crteensy/zeptoELRS/zepto_receiver_elrs_3d_top.png

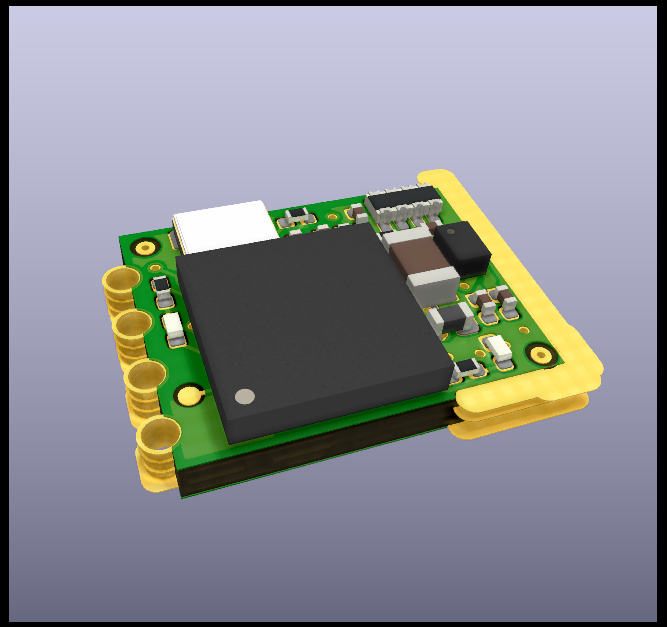
zepto_receiver_elrs_3d_top.png
