crteensy/zeptoELRS/zepto_receiver_elrs_3d_bot.png

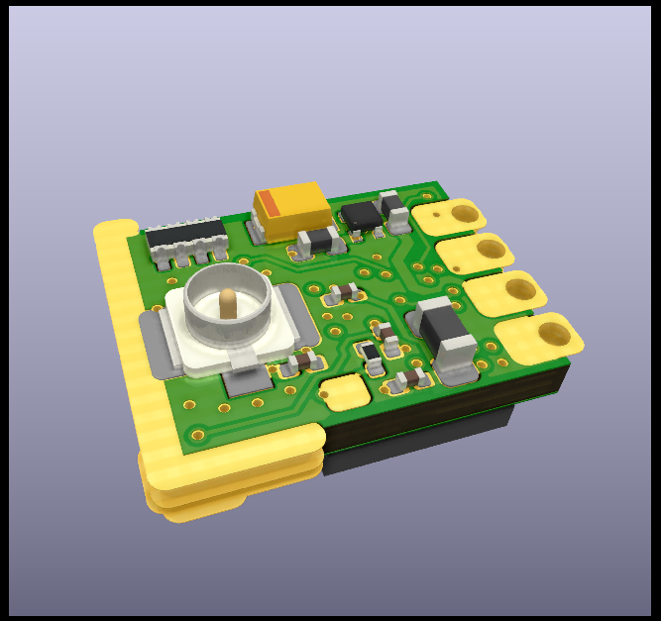
zepto_receiver_elrs_3d_bot.png
