crteensy/zeptoELRS/simulation/simple_plane_low_granularity/simple_plane_model_low_granularity.png

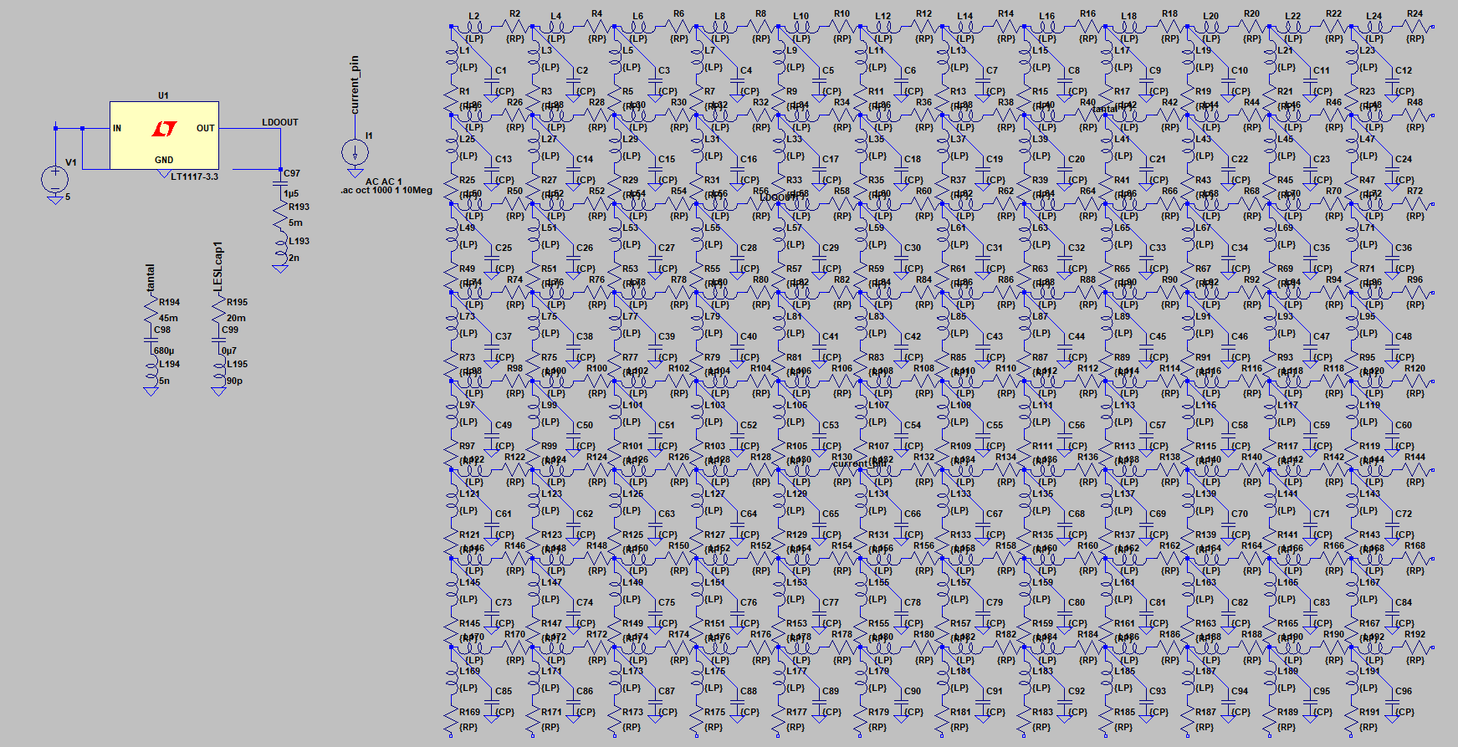
simulation/simple_plane_low_granularity/simple_plane_model_low_granularity.png
