crteensy/zeptoELRS/bom.pdf

Sheet1

Des. | Value | Price | Type
C1 | 1µF | 0,014 GRM033C80J105ME05J | | 1
C2 | 1µF | 0,014 GRM033C80J105ME05J | | 1
C3 | 10µF | 0,018 GRM155R60J106ME05J | | 1
C4 | 1µF | 0,014 GRM033C80J105ME05J | | 1
C5 | 10µF | 0,018 GRM155R60J106ME05J | | 1
C6 | 1µF | 0,014 GRM033C80J105ME05J | | 1
C7 | 2.2uF | 0,089 LLA185C70G225ME16L | | 1
C8 | 100nF | 0,007 JMK063BJ104KP-F | | 1
C9 | 2.2uF | 0,089 LLA185C70G225ME16L | | 1
C10 | 2.2uF | 0,089 LLA185C70G225ME16L | | 1
C11 | 2.2uF | 0,089 LLA185C70G225ME16L | | 1
C12 | 100uF | 0,234 F380J107MSALZT | | 1
C13 | 1nF | 0,05 | | 1
C14 | 10pF | 0,05 | | 1
C15 | 68pF | 0,014 GRM033C80J105ME05J | | 1
C18 | 33pF | 0,05 | | 1
C21 | 3.3pF | 0,05 | | 1
C26 | 3.3pF | 0,05 | | 1
D1 | LED_BLUE | 0,059 SML-LX0201USBC-TR | | 1
D2 | LED_WHITE | 0,053 SML-LX0201NWD-TR | | 1
FID1 | Fiducial | 0 | | 1
FID2 | Fiducial | 0 | | 1
FID3 | Fiducial | 0 | | 1
J1 | u.fl | 0,28 | | 1
L1 | 15µH | 0,103 BRL1608T150M | | 1
L2 | 33nH | 0,05 | | 1
L6 | 8.7nH | 0,05 | | 1
R1 | 270R | 0,003 RC0201FR-07270RL | | 1
R2 | 270R | 0,003 RC0201FR-07270RL | | 1
R3 | 10k | 0,003 RC0201FR-0710KL | | 1
R4 | 10k | 0,003 RC0201FR-0710KL | | 1
R5 | 100R | 0,004 RC0201FR-07100RL | | 1
R6 | 220R | 0,003 RC0201FR-07270RL | | 1
SW1 | SW_Push | 0 EVP-BL9A2B000 | | 1
TP1 | Pad 1x1mm | 0 | | 1
TP2 | Pad 1.5x1.5mm | 0 | | 1
TP3 | Pad 1.5x1.5mm | 0 | | 1
TP4 | Pad 1.5x1.5mm | 0 | | 1
TP5 | Pad 1.5x1.5mm | 0 | | 1
U1 | STM32WLE5JBI6 | 3,71 STM32WLE5JBI6 | | 1
U2 | NCP160 | 0,08 NCP160BMX330TBG | | 1
U3 | BGS12PL6E6327XTSA1 | 0,12 BGS12PL6E6327XTSA1 | | 1
U4 | 0900FM15D0039 | 0,2 0900FM15D0039 | | 1
U5 | ECS-TXO-25CSMV-320-AM-TR | 1,64 ECS-TXO-25CSMV-320-AM-TR | | 1
SUM | 7,317
