crteensy/zeptoELRS/zepto_receiver_elrs.pdf

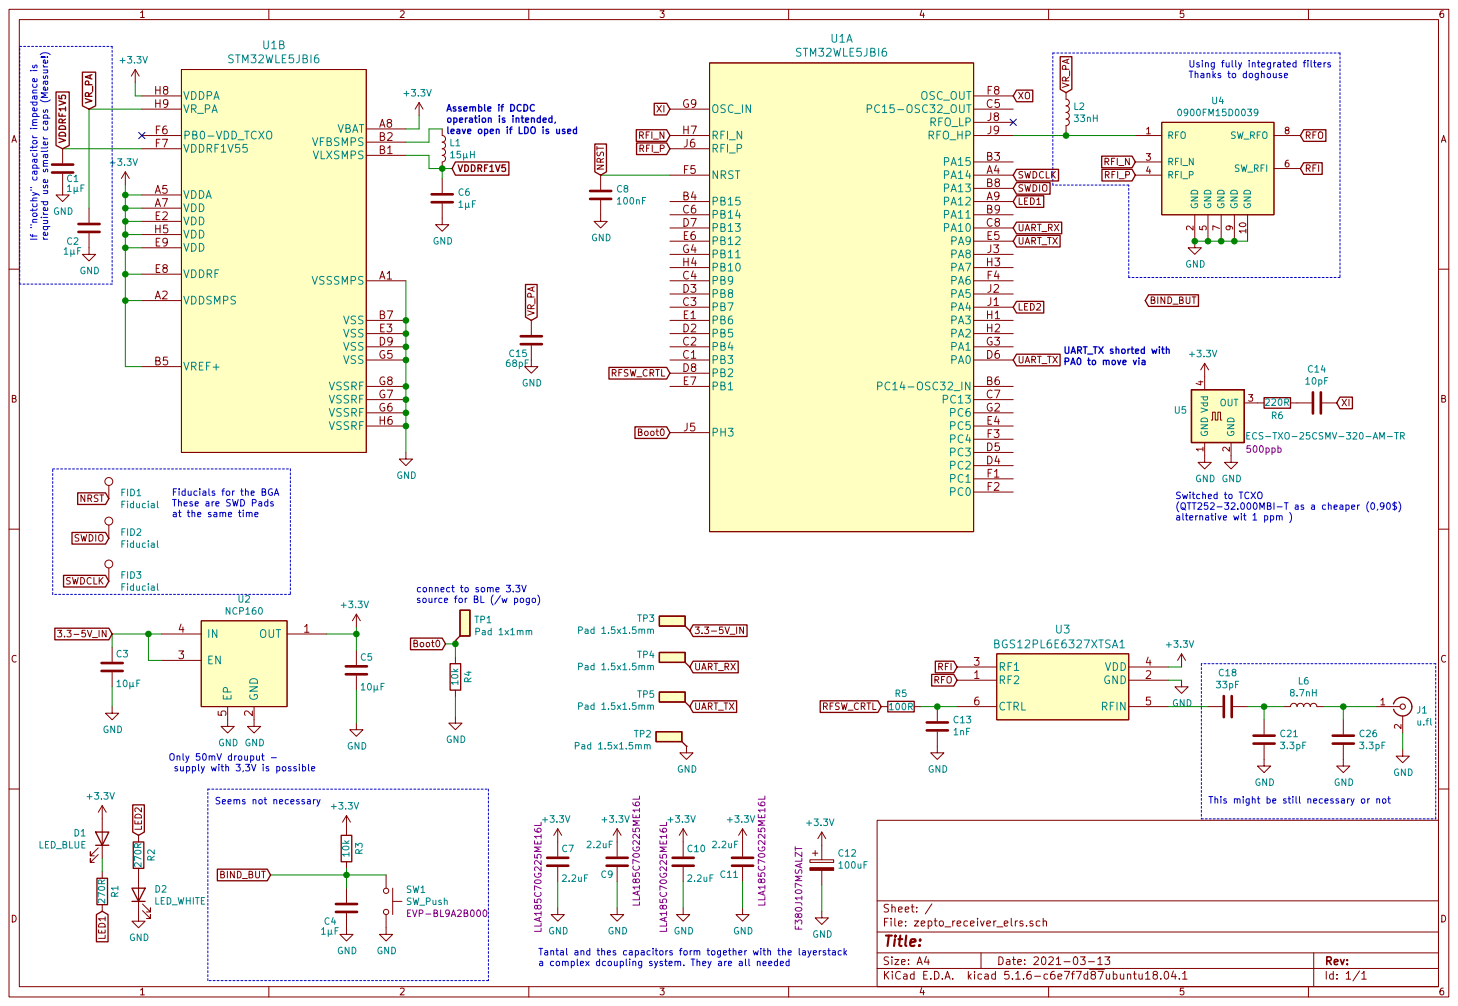
[picture p4: page 1]

Using fully integrated filters
Thanks to doghouse
0900FM15D0039 GND GND

alternative wit 1 ppm ) If "notchy" capacitor impedance is required use smaller caps (Measure!)

Assemble if DCDC
operation is intended,
leave open if LDO is used

4 U5 ECS-TXO-25CSMV-320-AM-TR

Fiducials for the BGA

connect to some 3.3V source for BL (/w pogo)

Tantal and thes capacitors form together with the layerstack
a complex dcoupling system. They are all needed
