crteensy/zeptoELRS/zepto_receiver_elrs.kicad_pcb

## KiCad design zepto_receiver_elrs.kicad_pcb (2021-03-14)

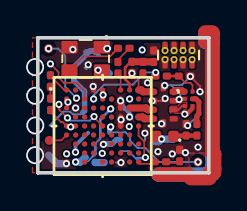
[picture p5: board zepto_receiver_elrs.kicad_pcb from above]

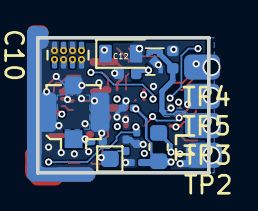
[picture p6: board zepto_receiver_elrs.kicad_pcb from below]

Board: 4 copper layers, 9.5 x 7.5 mm, 39 parts (17 on the bottom side), 29 nets.

Parts:
C1, C2, C6: 1µF; C_0201_0603Metric_dense
C3, C5: 10µF; L_0402_1005Metric_dense
C8: 100nF; C_0201_0603Metric_dense
C10: 2.2uF; 0805_low_esl_cap_avx
C11: 2.2uF; 0805_low_esl_cap_avx_w_via_dense
C12: 100uF; AVX_S_CASE
C13: 1nF; C_0201_0603Metric_dense
C14: 10pF; C_0201_0603Metric_dense
C15: 68pF; C_0201_0603Metric_dense
C18: 33pF; C_0201_0603Metric_dense
C21, C26: 3.3pF; C_0201_0603Metric_dense
D1: LED_BLUE; LED_0201_0603Metric
D2: LED_WHITE; LED_0201_0603Metric
FID1, FID2, FID3: Fiducial; Fiducial_0.5mm_Dia_1mm_Outer
J1: u.fl; U.FL_Molex_MCRF_73412-0110_Vertical
L1: 15µH; L_0603_1608Metric
L2: 33nH; R_0201_0603Metric_dense
L6: 8.7nH; L_0402_1005Metric_dense
R1, R2: 270R; R_0201_0603Metric_dense
R4: 10k; R_0201_0603Metric_dense
R5: 100R; R_0201_0603Metric_dense
R6: 220R; R_0201_0603Metric_dense
TP1: Pad 1x1mm; TestPoint_Pad_1.0x1.0mm
TP2, TP3, TP4, TP5: Pad 1.5x1.5mm; TestPoint_Pad_1.5x2mm
U1: STM32WLE5JBI6
U2: NCP160; UDFN-4_1x1mm_P0.65mm
U3: BGS12PL6E6327XTSA1
U4: 0900FM15D0039
U5: ECS-TXO-25CSMV-320-AM-TR; ECS-TXO-25CSMV-320-AM-TR_reduced_pads

Connections:
3.3-5V_IN: C3.1, TP3.1, U2.3, U2.4
+3V3: C5.1, C10.1, C11.2, C12.1, D1.2, U1.A2, U1.A5, U1.A7, U1.A8, U1.B5, U1.E2, U1.E8, U1.E9, U1.H5, U1.H8, U2.1, U3.4, U5.4
Boot0: R4.2, TP1.1, U1.J5
GND: C1.2, C2.2, C3.2, C5.2, C6.2, C8.2, C10.2, C11.1, C12.2, C13.1, C15.2, C21.2, C26.2, D2.1, J1.2, R4.1, TP2.1, U1.A1, U1.B7, U1.D9, U1.E3, U1.G5, U1.G6, U1.G7, U1.G8, U1.H6, U2.2, U2.5, U3.2, U4.2, U4.5, U4.7, U4.9, U4.10, U5.1, U5.2
LED1: R1.1, U1.A9
LED2: R2.2, U1.J1
NRST: C8.1, FID1.1, U1.F5
unnamed: C13.2, R5.1, U3.6
unnamed: C14.1, R6.2
unnamed: C18.1, U3.5
unnamed: C18.2, C21.1, L6.1
unnamed: C26.1, J1.1, L6.2
unnamed: D1.1, R1.2
unnamed: D2.2, R2.1
unnamed: L1.1, U1.B2
unnamed: L2.2, U1.J9, U4.1
unnamed: R6.1, U5.3
RFI: U3.3, U4.6
RFI_N: U1.H7, U4.3
RFI_P: U1.J6, U4.4
RFO: U3.1, U4.8
RFSW_CRTL: R5.2, U1.D8
SWDCLK: FID3.1, U1.A4
SWDIO: FID2.1, U1.B8
UART_RX: TP4.1, U1.C8
UART_TX: TP5.1, U1.D6, U1.E5
VDDRF1V5: C1.1, C6.1, L1.2, U1.B1, U1.F7
VR_PA: C2.1, C15.1, L2.1, U1.H9
XI: C14.2, U1.G9
