crteensy/zeptoELRS/obsolete_layouts/zepto_receiver_elrs_dicrete_passives.kicad_pcb

## KiCad design obsolete_layouts/zepto_receiver_elrs_dicrete_passives.kicad_pcb (2021-03-11, an earlier design)

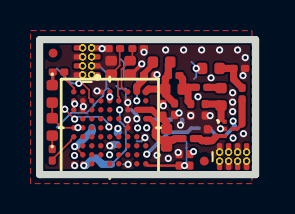
[picture p7: board zepto_receiver_elrs_dicrete_passives.kicad_pcb from above]

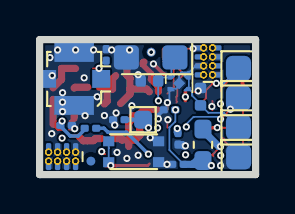
[picture p8: board zepto_receiver_elrs_dicrete_passives.kicad_pcb from below]

Board: 4 copper layers, 12.0 x 7.5 mm, 54 parts (23 on the bottom side), 29 nets.

Parts:
C1, C2, C4, C6: 1µF; C_0201_0603Metric_dense
C3, C5: 10µF; L_0402_1005Metric_dense
C7, C9, C10, C11: 2.2uF; 0805_low_esl_cap_avx_w_via_dense
C8: 100nF; C_0201_0603Metric_dense
C12: 100uF; CP_EIA-3216-18_Kemet-A
C13: 1nF; C_0201_0603Metric_dense
C14, C24: 1.2pF; C_0201_0603Metric_dense
C15: 2.2pF; C_0201_0603Metric_dense
C16: 5.6pF; C_0201_0603Metric_dense
C17, C23: 6.2pF; C_0201_0603Metric_dense
C18: 33pF; C_0201_0603Metric_dense
C19: 68pF; C_0201_0603Metric_dense
C20: 2.7pF; C_0201_0603Metric_dense
C21, C26: 3.3pF; C_0201_0603Metric_dense
C22: 3.6pF; C_0201_0603Metric_dense
C25: 1pF; C_0201_0603Metric_dense
D1: LED_BLUE; LED_0402_1005Metric_dense
D2: LED_WHITE; LED_0402_1005Metric_dense
FID1, FID2, FID3, FID4: Fiducial; Fiducial_0.5mm_Dia_1mm_Outer
J1: u.fl; U.FL_Molex_MCRF_73412-0110_Vertical
L1: 15µH; L_0603_1608Metric_Pad1.05x0.95mm_HandSolder
L2: 33nH; L_0402_1005Metric_dense
L3: 3.6nH; L_0402_1005Metric_dense
L4: 11nH; L_0402_1005Metric_dense
L5, L6: 8.7nH; L_0402_1005Metric_dense
R1, R2: 270R; R_0201_0603Metric_dense
R3, R4: 10k; R_0201_0603Metric_dense
R5: 100R; R_0201_0603Metric_dense
SW1: SW_Push; EVPBL9A2B000
TP1: Pad 1x1mm; TestPoint_Pad_1.0x1.0mm
TP2, TP3, TP4, TP5: Pad 1.5x1.5mm; TestPoint_Pad_1.5x1.5mm
U1: STM32WLE5JBI6
U2: NCP160; UDFN-4_1x1mm_P0.65mm
U3: BGS12PL6E6327XTSA1
Y1: 32MHz; XTAL_ECS-320-8-47-CKM-TR

Connections:
3.3-5V_IN: C3.1, TP3.1, U2.3, U2.4
+3V3: C5.1, C7.1, C9.2, C10.1, C11.2, C12.1, D1.2, D2.2, R3.2, U1.A2, U1.A5, U1.A7, U1.A8, U1.B5, U1.E2, U1.E8, U1.E9, U1.H5, U1.H8, U2.1, U3.4
BIND_BUT: C4.1, R3.1, SW1.1, U1.J1
Boot0: R4.2, TP1.1, U1.J5
GND: C1.2, C2.2, C3.2, C4.2, C5.2, C6.2, C7.2, C8.2, C9.1, C10.2, C11.1, C12.2, C13.1, C14.1, C16.1, C17.2, C20.1, C21.2, C23.2, C24.2, C25.1, C26.2, J1.2, R4.1, SW1.2, TP2.1, U1.A1, U1.B7, U1.B8, U1.D9, U1.E3, U1.G5, U1.G6, U1.G7, U1.G8, U1.H6, U2.2, U2.5, U3.2, Y1.2, Y1.4
LED1: R1.1, U1.A9
LED2: R2.1, U1.A4
unnamed: C8.1, U1.F5
unnamed: C13.2, R5.1, U3.6
unnamed: C14.2, C15.2, L2.2, L3.1, U1.J9
unnamed: C15.1, C16.2, C19.2, L3.2
unnamed: C18.1, U3.5
unnamed: C18.2, C21.1, L6.1
unnamed: C19.1, L5.1
unnamed: C26.1, J1.1, L6.2
unnamed: D1.1, R1.2
unnamed: D2.1, R2.2
unnamed: L1.1, U1.B2
RF1: C22.1, C25.2, U3.3
RF2: C24.1, L5.2, U3.1
RFI_N: C20.2, L4.2, U1.H7
RFI_P: C22.2, L4.1, U1.J6
RFSW_CRTL: R5.2, U1.J2
UART_RX: TP4.1, U1.C8
UART_TX: TP5.1, U1.E5
VDDRF1V5: C1.1, C6.1, L1.2, U1.B1, U1.F7
VR_PA: C2.1, L2.1, U1.H9
XI: C17.1, U1.G9, Y1.3
XO: C23.1, U1.F8, Y1.1
