crteensy/zeptoELRS/simulation/simple_plane_low_granularity/result_tantal_low_frequency.png

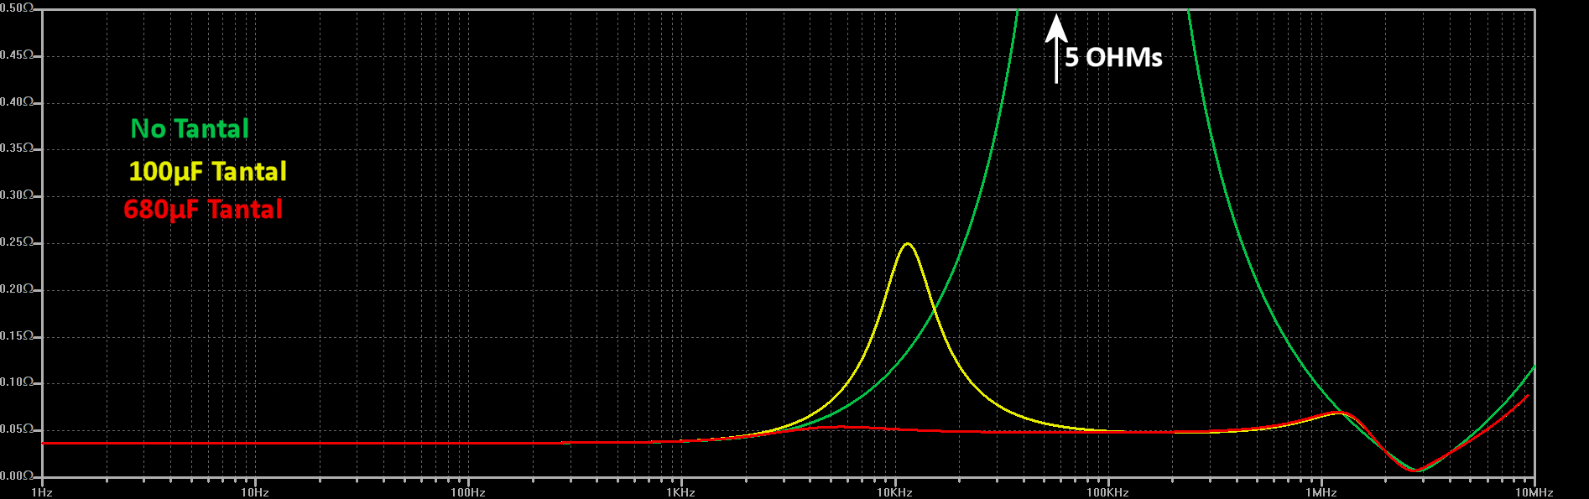
simulation/simple_plane_low_granularity/result_tantal_low_frequency.png
