crteensy/zeptoELRS/cubemx_blinky/Core/Inc/main.h

#define LED1_Pin GPIO_PIN_12
#define LED1_GPIO_Port GPIOA
#define LED2_Pin GPIO_PIN_4
#define LED2_GPIO_Port GPIOA
