crteensy/zeptoELRS/(commit log)

2021-03-10 added pdf schematic
2021-03-10 Routed half of the Layout, changed a few pins
    [zepto_reciever_elrs.kicad_pcb, zepto_reciever_elrs.sch]
2021-03-10 updated layout, adjusted courtyards, updated schematic pdf
    [zepto_receiver_elrs.kicad_pcb, zepto_receiver_elrs.sch, zepto_reciever_elrs.kicad_pcb]
2021-03-11 Added Integrated filter and TXCO
2021-03-11 Saved the routed layout with discretes in own file
    [zepto_receiver_elrs_dicrete_passives.kicad_pcb]
2021-03-11 new layout with integrated passives and TCXO
    [zepto_receiver_elrs.kicad_pcb, zepto_receiver_elrs.sch]
2021-03-11 update dimensions in layout
    [zepto_receiver_elrs.kicad_pcb]
2021-03-11 updated silk screen
    [zepto_receiver_elrs.kicad_pcb]
2021-03-12 Shrinked down reciever to 9.5x7.5mm
    [zepto_receiver_elrs2.kicad_pcb, zepto_receiver_elrs_rf_one_side.kicad_pcb]
2021-03-12 connect SWDIO in layout
    [zepto_receiver_elrs.kicad_pcb]
2021-03-13 adjust schematic, further layout work
    [zepto_receiver_elrs_20210313_1419.kicad_pcb]
2021-03-13 update schematic and layout
    [zepto_receiver_elrs.kicad_pcb, zepto_receiver_elrs.sch]
2021-03-13 moved a few components, checked pinout
    [zepto_receiver_elrs.kicad_pcb, zepto_receiver_elrs.sch]
2021-03-13 update sch, pdf and layout, add 3d views
    [zepto_receiver_elrs.kicad_pcb, zepto_receiver_elrs.sch, zepto_receiver_elrs2.kicad_pcb, zepto_receiver_elrs_20210313_1419.kicad_pcb, zepto_receiver_elrs_dicrete_passives.kicad_pcb, zepto_receiver_elrs_rf_one_side.kicad_pcb]
2021-03-14 Created panels, changed sideplating, added a few comments
    [panel_5x3-B_Cu.gbr, panel_5x3-B_Mask.gbr, panel_5x3-B_Paste.gbr, panel_5x3-Cmts_User.gbr, panel_5x3-Edge_Cuts.gbr, panel_5x3-F_Cu.gbr, panel_5x3-F_Mask.gbr, panel_5x3-F_Paste.gbr]
2021-03-14 added bom pdf and ods
    [bom.ods]
